MeiRain/DreamFly2/README.md

# DreamFly2

DreamFly2 是一个基于 STM32F411、HAL 和 FreeRTOS 实现的微型四轴飞行器项目。

项目源自本科阶段的 DreamFly。在保留原有硬件和飞行经验的基础上，新版本将重新整理驱动、算法、飞行控制和调试工具，最终实现室内低空的自稳、定高与光流定点飞行。

## 功能清单

### 工程基础

- [ ] 建立 STM32CubeMX + CMake + CLion 工程
- [ ] 接入 STM32 HAL 与 FreeRTOS
- [ ] 建立统一的工程目录、代码规范和调试接口
- [ ] 建立可重复编译和烧录的项目基线

### 板级驱动

- [ ] 系统时钟与基础定时
- [ ] 用户 LED
- [ ] WS2812B RGB 灯
- [ ] 四路空心杯电机 PWM
- [ ] 电池电压采样
- [ ] UART、SPI 与 I2C 总线
- [ ] 内部 Flash 参数保存

### 传感器与通信

- [ ] ICM20948 加速度计与陀螺仪
- [ ] BMP280 气压计
- [ ] 光流模块（vl53l1和pmw3901）
- [ ] 激光测距模块
- [ ] Si24R1 遥控通信
- [ ] ESP8684 Wi-Fi 调试数据传输

### 遥控器

- [ ] 建立 STM32F103 HAL 工程
- [ ] 双摇杆四通道 ADC 与电池电压采样
- [ ] 摇杆校准、死区和通道映射
- [ ] 六个功能按键
- [ ] 信息页切换、飞行模式选择与设置菜单
- [ ] OLED 状态显示
- [ ] WS2812B、状态 LED 与蜂鸣器提示
- [ ] NRF24L01 遥控数据发送与连接状态检测
- [ ] 内部 Flash 保存摇杆校准参数
- [ ] USB 转串口调试

### 飞行功能

- [ ] 传感器检测与 IMU 校准
- [ ] 姿态解算
- [ ] 角速度内环控制
- [ ] 姿态外环控制
- [ ] 电机混控
- [ ] 自稳飞行
- [ ] 高度估计与定高飞行
- [ ] 光流速度估计
- [ ] 室内低空光流定点
- [ ] 自动起飞
- [ ] 自动降落
- [ ] 解锁后四个电机低速短转提示

### 安全与调试

- [ ] 解锁与上锁状态管理
- [ ] 遥控失联保护
- [ ] 欠压保护
- [ ] 姿态异常保护
- [ ] 传感器异常处理
- [ ] PID 与传感器数据观察
- [ ] 飞行日志与问题记录

## 单回中油门约定

遥控器采用油门上下轴不回中的单回中设计；横滚、俯仰、偏航仍自动回中。油门松手保持当前杆位，最低 1000、中位 1500、最高 2000。

| 模式 | 油门含义 | 中位含义 |
|---|---|---|
| 自稳 | 杆位连续映射基础输出，驾驶者手动调节高度 | 固定杆量，不保证悬停，不强制映射悬停基准 |
| 定高 / 光流定点 | 上半请求上升、下半请求下降 | 手动放入 1450～1550 死区，请求保持高度 |

- **校准**：三轴居中、油门拉到底，采集三轴中点和油门最低值；旧版四中点参数不能直接沿用。
- **解锁待飞**：内八解锁，电机依次短转后停桨；三轴居中且油门 ≤1100 保持 200 ms，再上推。当前自稳台架到 ≥1200 启动，低杆 ≤1100 停止；中位不停止。
- **待飞保护**：提前推高不能启动；待飞 15 秒无操作自动上锁；失联或必要数据失效上锁，恢复后重新执行解锁和低杆确认。
- **正式模式**：定高／定点低杆是下降请求，不能套用台架低杆停机逻辑；落地后手动上锁，可靠落地检测接入后再实现自动上锁。

当前台架基础 PWM 已跟随 `油门值 − 1000`，单电机输出范围 0～1000，三轴修正仍各限 ±20；解锁短转仍为 PWM=100。横滚／俯仰已接角度—角速度双环，偏航按摇杆控制角速度；初始参数仍待验证，定高、定点和一键起降尚未接入。完整规则与 PX4 对照见 [单回中油门控制](docs/throttle.md)。

## 文档导航

| 文档 | 内容 |
|---|---|
| [文档索引](docs/README.md) | 全部开发文档与硬件资料入口 |
| [单回中油门控制](docs/throttle.md) | 单回中校准、低杆待飞、模式油门与落地上锁约定 |
| [遥控器操作](docs/remote_controls.md) | 按键分工、校准流程、解锁提示与一键起降规划 |
| [硬件配置与引脚映射](docs/hardware.md) | 飞控与遥控器硬件、外设接口和引脚对应关系 |
| [软件结构](docs/architecture.md) | 模块分层、依赖关系与数据处理原则 |
| [C 代码规范](docs/coding_style.md) | 命名、变量作用域、函数传值、头文件引用与注释 |
| [姿态解算](docs/attitude.md) | 新旧实现对比、运动修正条件与上位机方向映射 |
| [Flash 参数保存](docs/flash.md) | 参数区预留、构建配置、加载与保存 |
| [匿名上位机在线调参](docs/ano_parameters.md) | UART2/WiFi 连接、姿态增益读写、恢复默认与保存 |
| [遥控通信协议](docs/remote_protocol.md) | 控制包、状态包、字段单位与 ACK 约定 |
| [SI24R1 驱动](docs/si24r1.md) | 无线驱动接口与通信流程 |
| [开发与协作](docs/development.md) | 开发路线、分工与提交协作方式 |

## Flash 参数区配置

飞控使用末尾 128 KB（扇区 7）保存参数。在 `firmware/dreamfly2_flight/STM32F411xx_FLASH.ld` 的 `MEMORY` 中，将 Flash 的 `LENGTH = 512K` 改为 `384K`，RAM 配置不变：

```ld
FLASH (rx) : ORIGIN = 0x08000000, LENGTH = 384K
```

同时在飞控 `CMakeLists.txt` 的 `target_sources()` 中加入 `Core/Src/flash.c`。修改后重新构建。

`flight_init()` 自动加载参数；匿名上位机现已接入四个姿态解算增益的读取、修改、恢复默认和保存命令，支持 UART2 串口或 WiFi 双向透传。修改先在 RAM 生效，明确执行保存才写入 Flash；修改和保存要求飞控已上锁。UART2 报文读写、保存及掉电加载已通过实机验证；匿名上位机界面和 WiFi 透传尚待验证。详见 [在线调参](docs/ano_parameters.md) 和 [Flash 参数保存](docs/flash.md)。

## 项目状态

DreamFly2 正在重新整理和启动中。功能清单将随开发进度逐项更新。
