MeiRain/DreamFly2/docs/README.md

# 项目文档

[返回项目首页](../README.md)

## 使用与硬件

| 文档 | 内容 |
|---|---|
| [单回中油门控制](throttle.md) | 正式油门操纵约定、PX4 参考及当前台架差异 |
| [遥控器操作](remote_controls.md) | 功能键、微调键、校准与起降操作规划 |
| [硬件配置与引脚映射](hardware.md) | 飞控与遥控器硬件配置和接口表 |
| [硬件结构图](hardware_structure.png) | 飞控与遥控器硬件结构 |

## 软件设计与开发

| 文档 | 内容 |
|---|---|
| [软件结构](architecture.md) | 分层、模块依赖与实时处理原则 |
| [C 代码规范](coding_style.md) | 文件命名、函数接口、变量与注释规范 |
| [姿态解算](attitude.md) | 算法对比、修正门限与显示方向 |
| [Flash 参数保存](flash.md) | 预留 128 KB 参数区、默认值、有效性校验和保存接口 |
| [高度估计](height.md) | 气压相对高度、垂直加速度融合与调试输出 |
| [遥控目标映射](control_mapping.md) | 自稳/定高目标、油门死区和调试预览 |
| [开发与协作](development.md) | 开发路线和协作方式 |
| [板级验证](board_verification.md) | 高度回传、无线中断、遥控操作及拆桨电机验证记录 |
| [2026-10-27 实测记录](measurements/2026-10-27/README.md) | 气压与融合原始日志、统计及当前暂停位置 |

## 通信与驱动

| 文档 | 内容 |
|---|---|
| [匿名上位机在线调参](ano_parameters.md) | UART2/WiFi 参数列表、在线修改、恢复默认与保存 |
| [遥控通信协议](remote_protocol.md) | 遥控指令、飞控状态与链路约定 |
| [SI24R1 驱动](si24r1.md) | 驱动接口、ACK 和收发流程 |
