MeiRain/DreamFly2/docs/attitude.md

# 姿态解算实现对比

[返回项目首页](../README.md) · [文档索引](README.md)

三版均采用陀螺仪积分与加速度重力方向反馈的互补融合思路。DreamFly2 的区别主要是数据接口、状态管理和运动条件处理，并非全新的姿态算法。

| 对比项 | 原版 DreamFly | 江科大参考工程 | DreamFly2 |
|---|---|---|---|
| 输入与周期 | 原始计数经校准、滤波后输入；解算内部固定周期 | 加速度、角速度及 `dt` 由调用方传入，角速度单位为 °/s | `sensors` 提供校准、滤波后的 g、°/s；周期通过参数传入，当前任务设为 2 ms |
| 初始姿态 | 四元数从 `(1,0,0,0)` 开始 | 提供根据加速度初始化四元数的函数 | 首个有效加速度样本初始化 Roll、Pitch，Yaw 从零开始 |
| 六轴与九轴状态 | 当前飞行路径使用六轴 | 六轴、九轴函数共用全局四元数 | 六轴、九轴分别保存私有状态，可同时计算；六轴用于飞行开发，九轴用于演示 |
| 四元数积分 | 顺序更新，后面的分量使用已经更新的分量 | 同样顺序更新 | 先保存旧四元数，四个分量使用同一时刻的数据更新，再归一化 |
| 偏航角输出 | Z 轴角速度单独积分，设置 ±1°/s 死区；使用 `HALFT`，与四元数完整积分周期不一致 | 从四元数计算 Yaw，无该死区 | 从各自的四元数计算 Yaw，不忽略缓慢转动 |
| 加速度零值处理 | 任意一轴为零即退出，可能跳过正常样本 | 三轴全部为零才退出，避免归一化除零 | 六轴加速度不可靠时继续陀螺仪积分，不退出整个解算 |
| 动态重力修正 | 无加速度模长门限 | 无加速度模长门限 | 六轴只在加速度模长为 0.85～1.15 g 时使用重力方向修正 |
| 修正积分 | 每次累加重力方向误差 | 每次按 `dt` 累加重力方向误差 | 六轴仅在上述模长范围内、且每轴角速度均不超过 20°/s 时累加；其他时候保留已有积分修正 |

## 新版运动条件处理

加速度计在运动时测到的是重力与运动影响的合成量。模长明显偏离 1 g 时，暂停新的重力反馈；较快转动时，暂停修正积分累加，减少运动加速度和滤波滞后被积累为长期修正的机会。陀螺仪积分仍持续执行。

0.85～1.15 g 和 20°/s 是针对手持剧烈运动测试新增的初始参数，不来自旧版或江科大参考工程，也不是固定标准。目前仅完成初步手持验证，尚未验证飞行效果。模长接近 1 g 不保证没有运动干扰；这些门限也不能消除六轴的绝对航向不可观测问题。后续需检查采样周期、传感器饱和、零偏和动态误差，不能仅凭门限认定漂移根因已解决。

## 上位机方向映射

内部姿态和控制使用一致的机体坐标系。发送 ANO `0x03` 姿态帧时，在 `debug_send_attitude()` 中保留 Roll，对 Pitch、Yaw 取负，以匹配旧版上位机显示方向。该转换只作用于输出显示，不改变传感器数据或内部姿态状态。

实现文件：[`attitude.c`](../firmware/dreamfly2_flight/Common/attitude.c)、[`sensors.c`](../firmware/dreamfly2_flight/Application/sensors.c)、[`debug.c`](../firmware/dreamfly2_flight/Application/debug.c)。
