MeiRain/DreamFly2/docs/throttle.md

# 单回中油门控制约定

[项目首页](../README.md#单回中油门约定) · [遥控器操作](remote_controls.md) · [当前代码与台架](control_mapping.md)

设计确定日期：2026-10-29。本版替代此前双回中设计。只有油门上下轴不回中，偏航、横滚、俯仰仍回中；油门松手后保持当前杆位。所有通道仍为 1000～2000，通信包长度和字段不变。

## 摇杆采样与校准

- 校准时三轴居中、油门拉到底，按 5 ms 间隔取 60 次新样本，计算三轴中点和油门最低 ADC 值。
- 三轴中点允许 1024～3072，油门最低值允许 0～1024；姿势不符时失败，不覆盖旧参数。
- 各轴先独立均值滤波。三轴按各自中点映射到 1000～2000，保留 ±10 的中位死区；油门从实测最低值到理论 4095 映射到 1000～2000，仅保留底部 10 个通道单位的死区，不吸附到 1500。
- 尚未校准时三轴中点默认 2048、油门最低默认 0。未加入完整行程端点校准，最高端仍可能略低于 2000。
- 参数字段由 `throttle_center_adc` 改为 `throttle_min_adc`；旧四中点参数不能直接加载，需重新校准。当前只更新 RAM，遥控器 Flash 保存和上电加载尚未实现。

## 各模式的油门含义

| 模式 | 杆量控制 | 手动放在中位 | 最低位置 |
|---|---|---|---|
| 自稳 | 连续基础输出，手动维持高度 | 固定杆量，不保证悬停 | 零基础输出候选；实际停机由状态和输出策略决定 |
| 定高 | 垂直速度 | 目标升降速度为零，并由高度闭环保持高度 | 请求下降，不是停桨命令 |
| 光流定点 | 垂直速度；水平由光流等估计和控制 | 垂直目标同定高，三轴中位另用于水平及偏航指令 | 请求下降，不是停桨命令 |

自稳沿用 `throttle - 1000` 生成 0～1000 的候选基础 PWM，不再强制“中位=悬停基准”。实际电机驱动上限为 1000（ARR=999 时为100%占空比），当前台架另有限幅；候选值不是推力或电机转速。悬停位置要实测，电量、姿态和载荷变化都可能需要手动修正。横滚、俯仰中位请求水平姿态，偏航中位请求零角速度；六轴解算不保证绝对航向不漂移。

定高、光流定点采用中位 1450～1550 的零升降速度死区，杆量高于死区请求上升，低于死区请求下降；当前定高候选上限为 ±0.5 m/s。机械不回中，因此驾驶者必须手动回到中位才能停止升降请求。定高候选已存在，光流定点映射和两者完整控制闭环尚未实现。

## 解锁与运行入口

1. 上锁时不因杆量启动电机。内八保持 1.5 秒解锁，松开后再次内八上锁。
2. 保留 M3→M4→M1→M2（左前→左后→右后→右前）的依次短转：每个 200 ms，间隔 300 ms，随后停桨等待。
3. 短转结束后，横滚、俯仰、偏航在 1450～1550，油门 ≤1100，连续保持 200 ms，才进入等待上推。短转期间的低杆不计入；提前推高必须重新拉低确认。
4. 当前自稳台架油门 ≥1200 授予运行许可，不再要求油门居中或达到 1600。启动时三轴仍需居中；等待上推时偏离三轴中位会取消确认，需重新完成第 3 步。启动后允许三轴运动。
5. 若以后接入定高类模式，摇杆起飞入口使用 ≥1600，避免从低杆经过中位时触发；该入口检查不代表高度控制已经实现。一键起飞保留 SW4 长按规划，须待对应控制和动作确认接入。
6. 待飞阶段保留 15 秒无操作自动上锁，运行后不按无操作计时自动上锁。起飞请求／运行许可不等于已经离地。

## 当前台架与正式飞行的边界

当前 `FLIGHT_RATE_TEST_ENABLED=1`，基础 PWM 使用 `油门值 − 1000`，范围0～1000；每轴修正仍为 ±20，混控后每电机限制0～1000。已移除固定基础100和台架160上限，推杆会实际增加输出。解锁顺序短转独立保留PWM=100。油门 ≤1100 停止并重新进入待飞确认，1101～1199 为启动后的滞回区间；1500 不停止。

台架失联、必要 IMU 无效或内环结果过期时上锁，恢复后不会自行重转。当前已接入手动基础油门、横滚／俯仰角度—角速度双环和偏航摇杆角速度目标，初始参数尚未调好；定高、定点和自动起降未接入。关闭台架开关仍只做计算预览，除解锁短转外不驱动电机。

双环已接入，下一步核对反馈方向、调节内外环参数并验证控制权限；定高／定点低油门必须保持下降控制，不能沿用台架低杆停机。首次正式飞行接入前需分别检查各模式的输出、最低推力和失效处理。

## 模式切换与降落

- 油门不回中不消除模式切换差异：自稳中的固定推力杆位，在定高中可能是升降速度请求。切入定高／定点时需将杆量放入中位并平滑承接输出；退出到自稳也需处理当前实际输出与手动杆量的差异。
- 只允许切入估计与控制均可用的模式，不能只改显示标志。模式切换当前仍未接入，不新增未经验证的空中切换行为。
- 正式自稳靠减小推力降落；定高／定点靠低杆请求下降。落地后保持低杆并手动内八上锁；不能单用低油门、气压高度为零或短时静止判断落地。
- 后续落地检测结合离地经历、低输出、运动和有效测距等证据持续确认，确认后停桨并上锁。尚未实现自动落地检测，不能宣称接地会自动上锁。
- 上锁或失效后，新的启动必须重新完成解锁和低杆确认，不能因恢复通信、重复包或原杆量保持偏高就自动重启。已明确请求的受控降落也不能被按键重传解释成起飞。

## PX4 参考

PX4 自稳使用推力映射，定高／定点使用垂直速度控制。PX4 支持悬停推力重映射，也可选择不重映射；本项目现阶段选择简单的直接杆量候选映射，不强制中位悬停。PX4 定高文档的地面起飞阈值为全行程 62.5%；本项目低杆确认、1200 台架启动、1600 预留定高入口和解锁短转均为项目约定，并非照搬 PX4。

PX4 的落地检测有接地、可能已落地、已落地的持续确认，自动上锁还受 `COM_DISARM_LAND` 延时影响。它同样不能保证物理接地瞬间已上锁。

核对日期 2026-10-29；源码参考固定至 v1.17.0，在线文档可能随版本更新。

- [PX4 自稳与油门曲线](https://docs.px4.io/main/en/flight_modes_mc/manual_stabilized)
- [PX4 定高](https://docs.px4.io/main/en/flight_modes_mc/altitude)
- [PX4 定点](https://docs.px4.io/main/en/flight_modes_mc/position)
- [PX4 落地检测](https://docs.px4.io/main/en/advanced_config/land_detector)
- [v1.17.0 自稳油门曲线实现](https://github.com/PX4/PX4-Autopilot/blob/v1.17.0/src/modules/mc_att_control/mc_att_control_main.cpp)
- [v1.17.0 解锁检查](https://github.com/PX4/PX4-Autopilot/blob/v1.17.0/src/modules/commander/Commander.cpp)
