MeiRain/DreamFly2/docs/hardware_structure.png

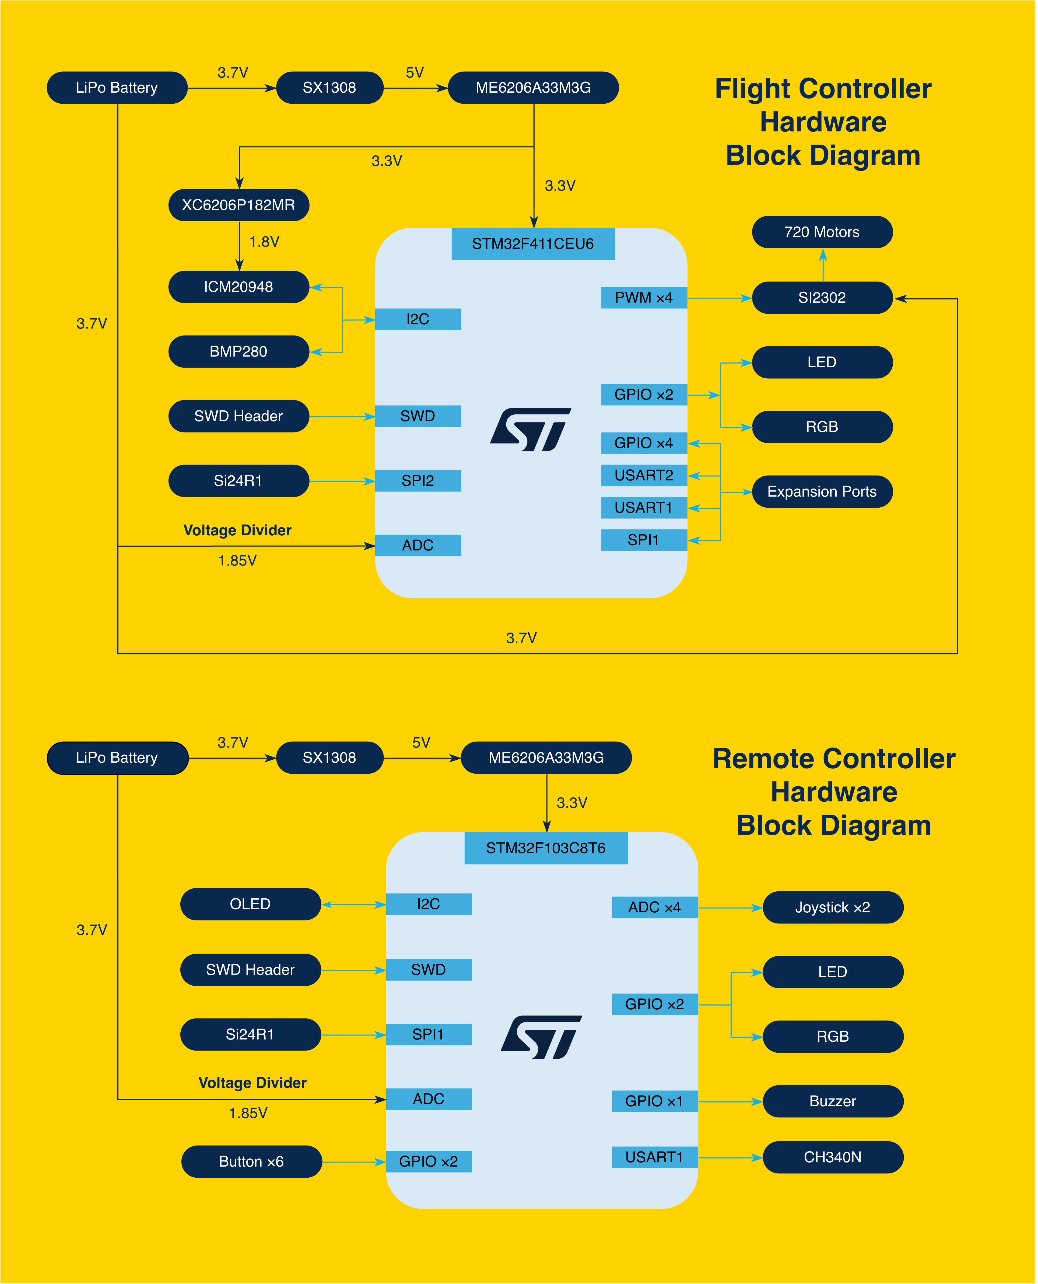
docs/hardware_structure.png
