MeiRain/DreamFly2/hardware/dreamfly/dreamfly2_data_transfer.png

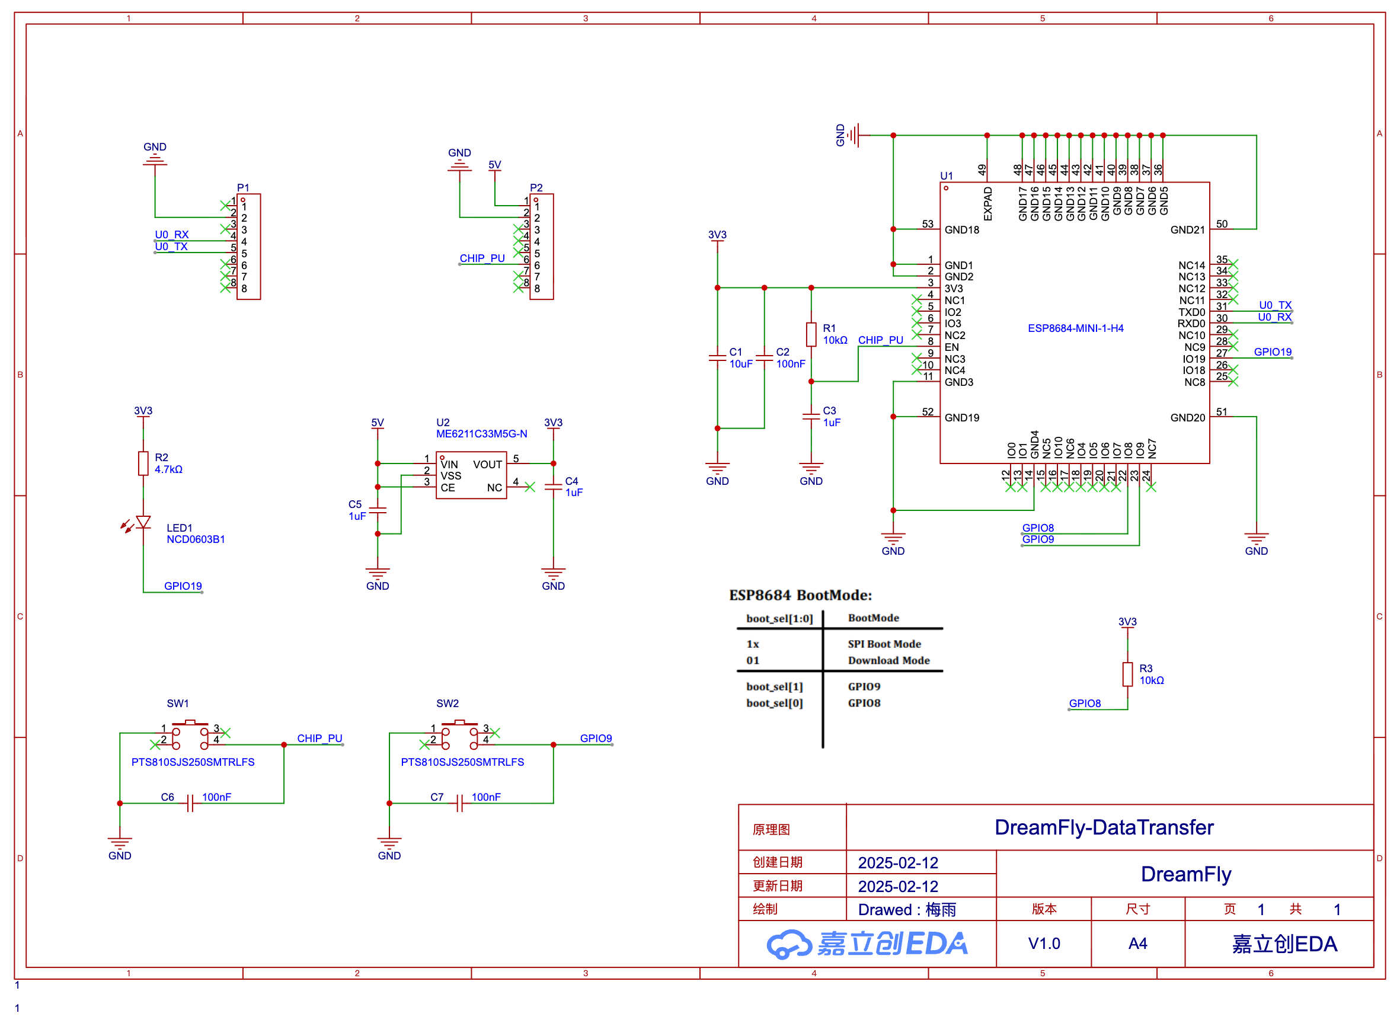
hardware/dreamfly/dreamfly2_data_transfer.png
