MeiRain/DreamFly2/hardware/dreamfly/dreamfly2_flight.png

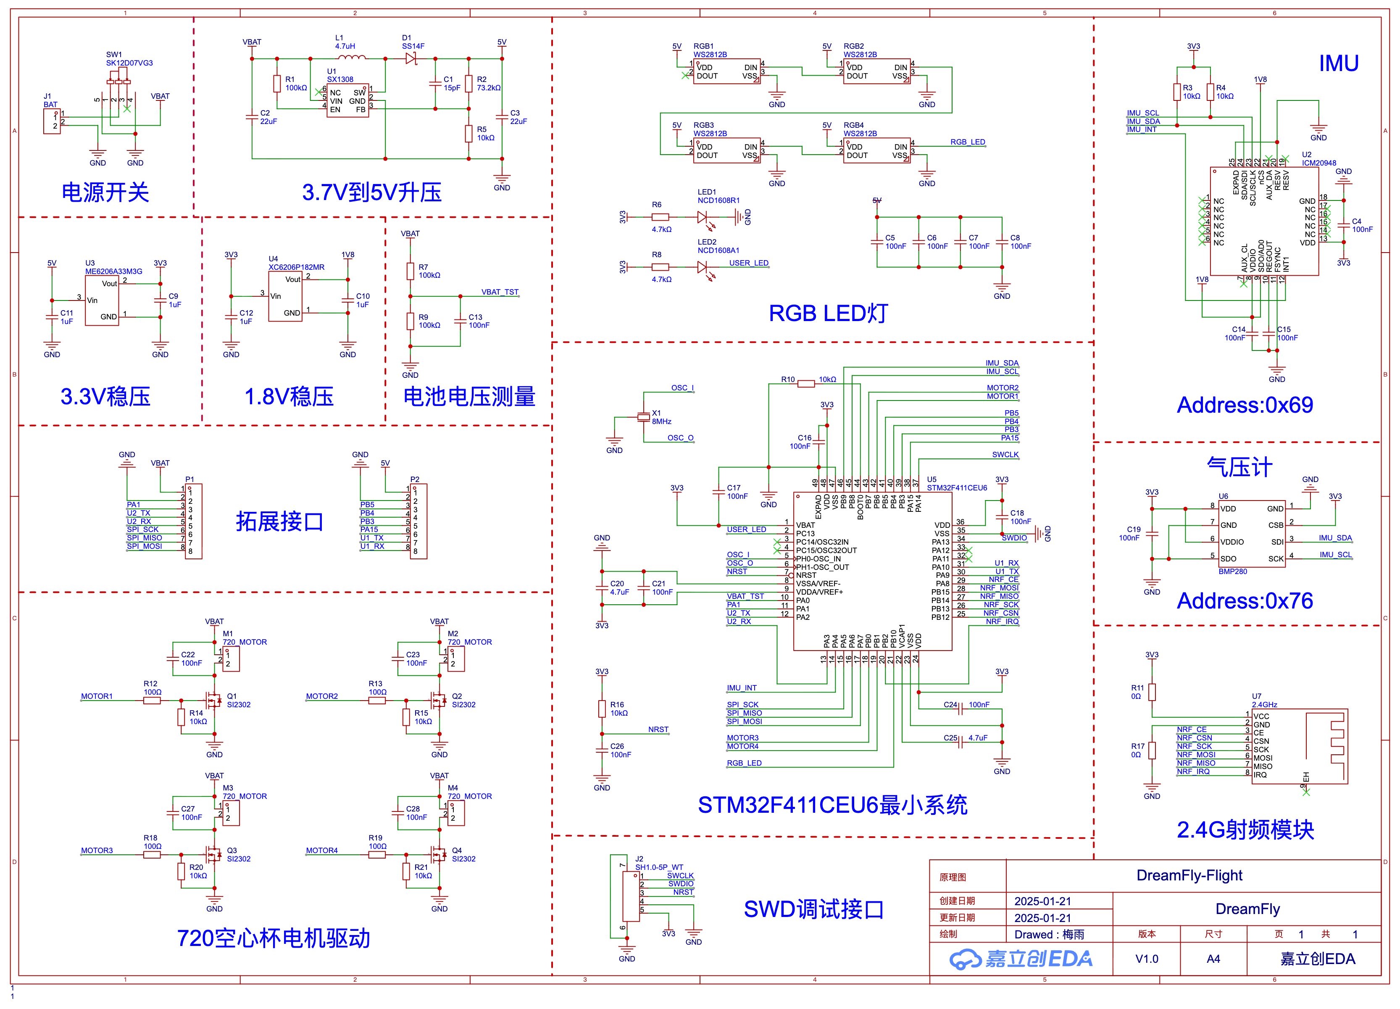
hardware/dreamfly/dreamfly2_flight.png
