MeiRain/DreamFly2/hardware/dreamfly/dreamfly2_optical_flow.png

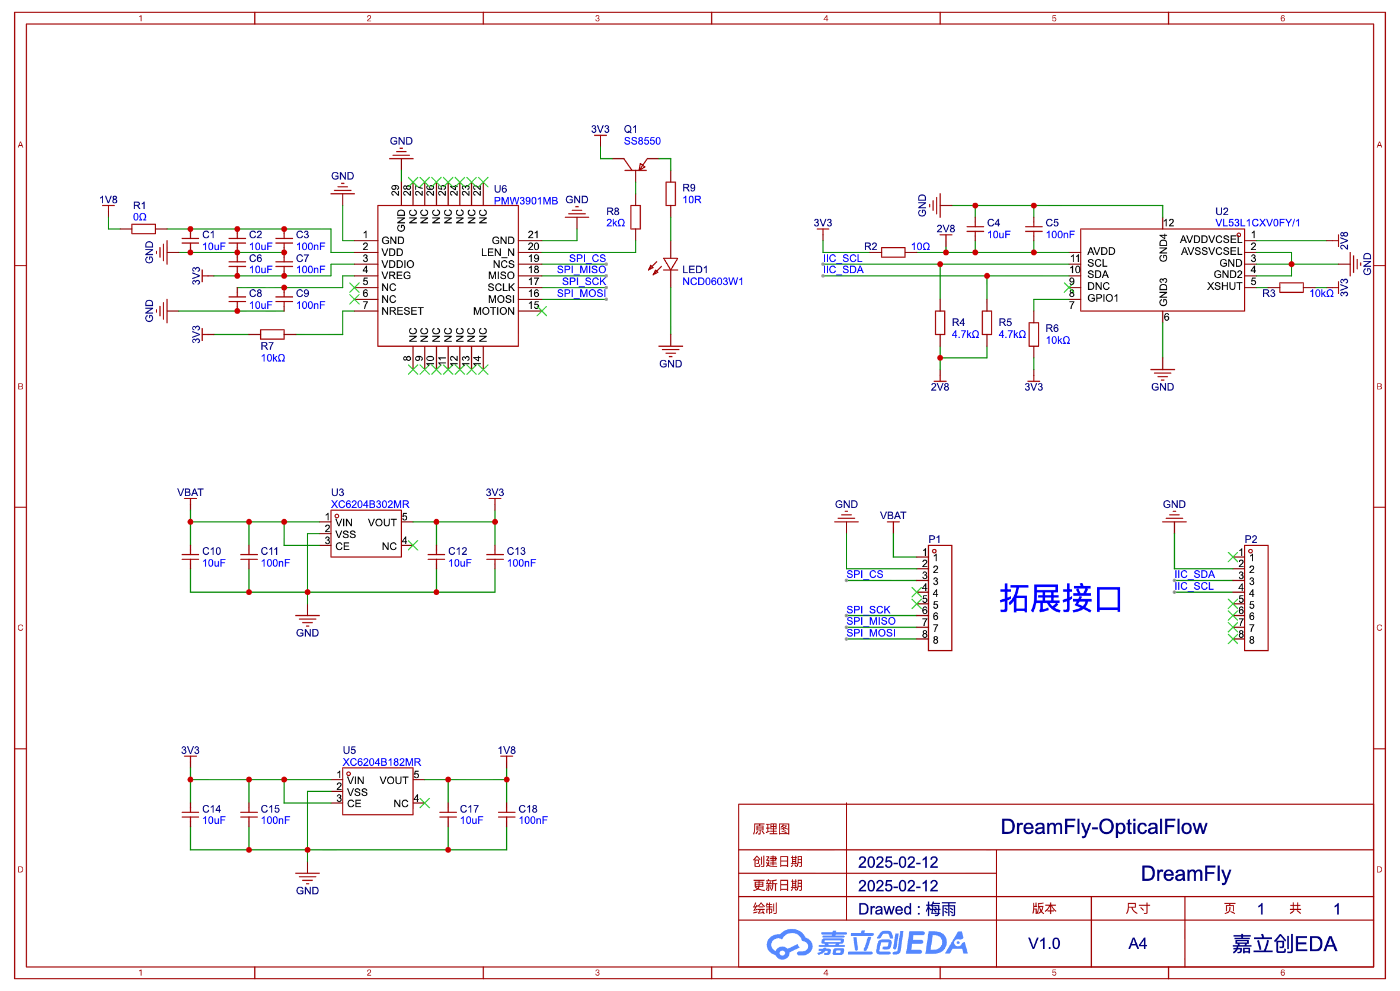
hardware/dreamfly/dreamfly2_optical_flow.png
