MeiRain/DreamFly2/hardware/dreamfly/dreamfly2_remote.png

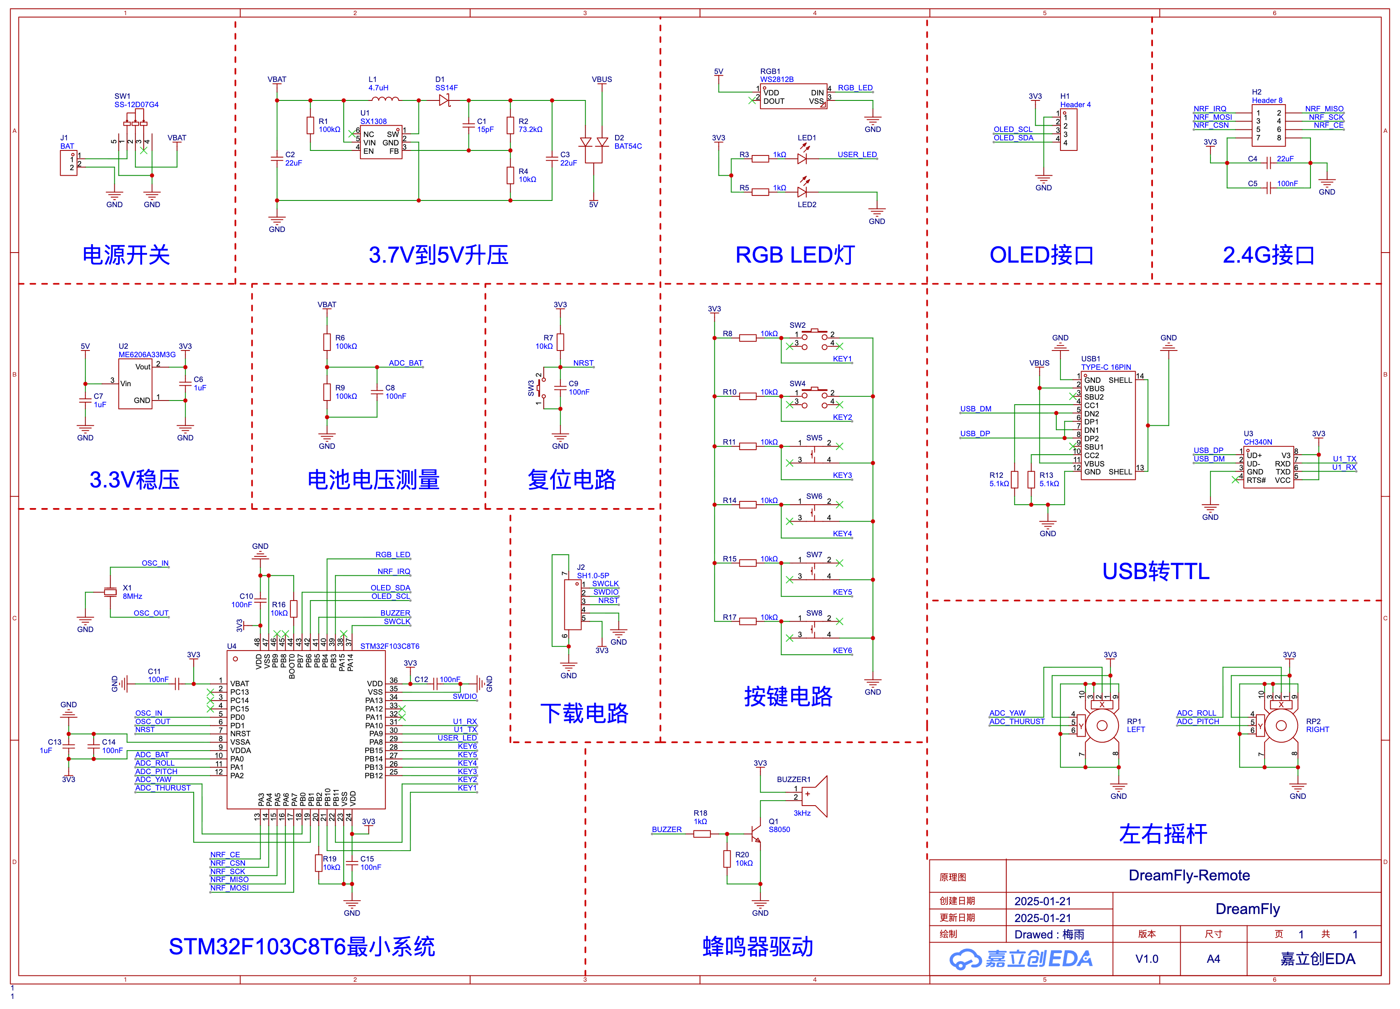
hardware/dreamfly/dreamfly2_remote.png
