MeiRain/DreamFly2/docs/measurements/2026-10-27/README.md

# 2026-10-27 气压高度与融合验证

[文档索引](../../README.md) · [高度估计](../../height.md) · [统计表](statistics.csv)

## 暂停位置

用户已暂时没有板子，停止板级采集。保留当前参数，不凭现有日志继续猜测调参。遥控通道到自稳/定高候选目标的映射已离线实现并接入调试，见[目标映射](../../control_mapping.md)，实际飞行电机输出仍未接入。下一步可接横滚/俯仰角度外环的候选输出；恢复板级验证时先补角度、去重力竖直加速度诊断，再定位倾斜假升降。

当前固件：BMP280 气压×16、温度×2、IIR4、0.5ms待机，任务50ms读取。气压地面零点仍是前32次有效海拔均值。融合位于 `Common/height.c/.h`，传感器任务调用，UART1对比 `H/F/Vz`；遥控器继续回传气压高度。用户已添加CMake源文件并自行编译、下载；本次代理没有编译或烧录。

## 关键数据与结论

| 记录 | 数据 | 结论与限制 |
|---|---|---|
| 已确认重新编译后的气压静置 | H=+7～+43cm，均值26.5cm，标准差8.71cm | 零点存在偏移，短时噪声仍明显 |
| 同轮抬高保持 | H均值85.81cm，标准差8.17cm | 相对本轮原位增加约59cm，方向正确 |
| 同轮放回 | 最后两个5秒窗口均值22.6、28.1cm | 接近原位；用户说明放回前等了一会，不能把整段等待算成传感器延迟 |
| 融合静置 | H标准差8.62cm；F标准差6.93cm；Vz=−8～+2cm/s | 这段融合更平滑，但速度仍有残差；不是定高控制验证 |
| 融合抬升 | Vz峰值约+31cm/s，F随抬升增加 | 上升方向初步验证；无精确位移、速度真值 |
| 融合放回 | Vz最低约−51cm/s，之后逐渐回零附近 | 下降方向初步验证，仍有数cm/s残差 |
| 原地倾斜 | H=−39～+12cm；F=−40～+11cm；Vz=−13～+8cm/s | 没有持续发散，但假升降明显；未同步记录Roll/Pitch/竖直加速度，不能确认重力补偿通过 |

用户反馈：电机依次转动正常，可记为该提示效果的实测反馈，不能据此认定失联保护、全部手势和实际飞行控制已通过。飞控 `rx` 和PB2 `irq` 计数增长已读到；遥控器PB3实际中断触发未单独证明，因仍有周期兜底。

## 不能混用的旧记录

- `dreamfly2_height_stage*.json`：最早的IIR16轮次，位置/环境未完全控制；不据此宣称传感器精度。
- `dreamfly2_height_filter4_stage*.json`：气压×4、温度×1、IIR4轮次。用户说明位置变到了灯泡附近/不同格子，温度条件也改变，不能直接归因于滤波系数。
- **`dreamfly2_height_os16_filter4_stage*.json` 文件名有误导性**：当时Debug ELF生成于13:51，而×16/50ms源码修改于13:57，尚未重新编译。该组不能作为新配置结果。原文件名保留用于追溯，统计表明确标记排除。
- `dreamfly2_height_os16_rebuilt_stage*.json`：核对ELF与相关目标文件均更新到14:01之后的有效新配置轮次。
- `dreamfly2_height_fusion_*.json`：核对 `height.c.obj` 和ELF更新到14:24之后的融合轮次。

## 原始日志格式与后续待办

每个JSON是 `[记录开始后的秒数, 串口原文]` 数组，保留该段收到的全部文本。它没有精确动作时间戳；“看到提示”与实际抬升/放回时间不完全同步，不能用采集开始时间直接计算阶跃延迟。UART1诊断约每400ms一行，统计表基于打印后的整数值，不代表完整500Hz融合数据。包含运动的整段标准差不能当作静态噪声。

尚待验证/处理：

- 同步Roll、Pitch、去重力竖直加速度，检查固定倾角保持后的残余加速度，区分姿态误差、滤波滞后、手持位移和气压干扰。
- 当前前32次气压均值没有“温度稳定后再归零”的处理；飞行中不应持续重新归零。
- 融合参数是台架起点，尚未完成定高PID、融合高度回传或飞行闭环。起飞请求只锁存，不实际起飞。
- 下次采集应固定位置、握持方式与环境，并明确动作时刻；不急于继续增加软件滤波或温漂补偿系数。
