MeiRain/DreamFly2/docs/board_verification.md

# 板级验证记录

[文档索引](README.md)

当前操作以单回中验证章节为准；下方旧版回中入口及日志保留作历史记录，不作为当前下载指引。历史检查包括无线中断、双向回传、按键与摇杆、传感器显示、解锁与电机顺序提示、回中后的起飞请求。全部实机结果仍待填写，代码检查不代表板级通过。先拆除四个螺旋桨；当前固件解锁后会实际启动电机提示，尚未实现飞行、定高或自动起降。

## 单回中修改后的验证（2026-10-29，待验证）

本版飞控和遥控器均需由用户重新编译下载，底层配置与通信包不变。油门上下轴不回中，三轴仍回中。先拆桨；当前仍是限幅台架，不是正式飞行控制。

1. 上锁且连接正常，在 REMOTE 页将三轴居中、油门拉到底，长按 SW2 校准。成功后检查三轴约1500、油门最低1000；油门全程不应在1500附近吸附。
2. 内八解锁，确认 M3→M4→M1→M2 依次短转，随后停转。若提前推高并保持，短转结束后仍不能启动台架。
3. 三轴1450～1550、油门≤1100保持至少200 ms，确认U1 `O`四路为0、`run=0`。保持三轴居中，上推到≥1200，确认`run=1`，油门1200静止时O接近200。
4. 将油门移到1500再放低至1200，台架应持续运行；拉低到≤1100才停止。未重新低杆确认200 ms就立即推高，不能重启。
5. 等待上推时先偏转一个姿态轴，确认本次准备被取消，必须重新三轴居中且低杆确认才能启动。
6. 运行中断开遥控器，确认失联上锁停转；恢复连接、保持高杆不能自行重转。再次启动需重新解锁与低杆确认。
7. 解锁待飞15秒无操作应自动上锁；启动后不因杆量保持不动而触发这项待飞超时。校准期间停止控制包发送的既有行为保留。

当前基础PWM使用`油门值−1000`，三轴修正±20，每电机0～1000；继续上推会增加输出，解锁短转独立保留PWM=100。本轮未编译、烧录或板测。详情见[单回中油门](throttle.md)和[台架模式](control_mapping.md#拆桨角速度台架模式)。

## 双环接入后的核对（2026-10-29，待验证）

当前飞控已由三轴零角速度试验改为横滚／俯仰双环，偏航直接跟随摇杆角速度。此前单环“倾斜后停止运动，四路恢复相同”的预期已不适用；三轴回中但机体倾斜时，应持续产生扶平修正。

先上锁、拆桨，通过U1核对：右倾保持时S横滚为负，M1/M2增大；低头保持时S俯仰为负，M2/M3增大；放平后修正减小。O上锁时仍为0。右推偏航杆对应负S偏航、M1/M3增大；松手目标角速度为0，不请求回到原航向。

外环初值P=3、输出±100deg/s，内环保留P=2、I=D=0、输出±20PWM计数。积分门控和同帧传感器发布已接入；未编译、烧录或板测。当前PID参数不在已有四参数Flash记录中。完整流程与日志字段见[串级控制](control_mapping.md)。

## 冷启动全红闪烁排查（2026-10-29，待验证）

四颗RGB一起红闪对应IMU初始化／陀螺仪校准失败，或水平加速度校准失败。代码检查发现首次访问ICM20948前缺少上电等待；手册的寄存器可访问时间最长100 ms，重新烧录造成的额外上电时间可能掩盖此缺口，但尚不能仅凭现象确认根因。

本版在首次寄存器访问前等待100 ms，保留复位后100 ms等待，配置后额外等待50 ms再采集校准。初始化／陀螺仪采集失败最多重新尝试三次；保持原有运动判断和水平校准门限，不绕过校准、不修改Flash参数、不在飞行任务中自动重初始化。

U1无效行新增`boot`：`boot=0`表示IMU配置或陀螺仪校准未完成；`boot=1 cal=0`表示水平加速度校准失败；`boot=1 cal=1 imu=0`表示启动校准通过但当前采样／姿态无效。各失败均保持不允许解锁。RGB仍报告故障，不因重试失败而隐藏。

用户编译下载后，拆桨、机体水平静置，分别重复完全断电上电及复位启动。成功后再验证单回中入口。若再红闪，保留异常状态并提供U1（115200）完整`rate: INVALID ...`一行，先区分失败阶段，不反复烧录覆盖现象。本版未编译、烧录或板测。

[ICM20948官方手册，第14页上电时序、第11页陀螺仪启动时间](https://product.tdk.com/system/files/dam/doc/product/sensor/mortion-inertial/imu/data_sheet/ds-000189-icm-20948-v1.5.pdf)

## 历史下载与观察（旧版流程）

以下轮播日志及相应检查步骤是早期验证格式。当前 UART1 已改为每 20 ms 单行输出角速度内环和混控预览，不再输出这些历史日志；当前格式见 [混控计算预览](control_mapping.md#角速度内环与混控计算预览)。

由用户编译、下载飞控；遥控器使用已有支持 18 字节状态包的版本即可，本次未修改遥控器。无需增加源文件或调整 CubeMX/CMake。飞控 UART1 为 115200、8N1，UART2 保留现有匿名姿态输出。

UART1 每 100 ms 选择一条消息输出，状态变化消息优先；普通情况下轮流出现遥控、板级和气压诊断消息：

```text
rc: OK rx=123 seq=122 R=1500 P=1500 Y=1500 T=1500 K=00
board: imu=1 cal=1 mag=1 baro=1 V=3.85 H=+12cm arm=0 req=0 irq=130
baro: P=101370.00Pa T=28.00C H=+12cm F=+10cm Vz=+1cm/s age=8ms
target[STAB]: R=0.0deg P=0.0deg Y=0.0dps Th=500 Vz=0.000m/s (preview)
```

- `imu/cal/mag/baro`：IMU、加速度校准、磁力计和气压计的初始化/校准结果，不等同于实时健康监测。
- `V`：飞控电池电压；0.00 表示尚无可用值，不代表物理电池一定为零。
- `baro`诊断行的`P/T`：BMP280输出的补偿气压和温度（仍受芯片滤波影响）；`age`：距上次成功读取的毫秒数。`F/Vz` 为融合高度/升降速度（cm、cm/s），向上为正，无有效融合结果时为横线；融合参数尚待实测。
- `H`：气压相对高度；`----` 表示参考未就绪、数据过期或超出协议范围。
- `arm`：解锁状态；`req`：油门起飞请求锁存值，不是已经起飞。
- `irq`：飞控 PB2 回调实际收到的无线中断次数，正常通信时应增长；它不等于包数，也不能单独证明遥控器 PB3 中断正常。
- `target`：新加入的映射预览，单位为deg、deg/s和m/s；其中Vz为目标速度，与baro行中的估计Vz不同。尚未接入PID、电机或模式切换，见[目标映射](control_mapping.md)。
- `rx`：飞控接受的有效新控制包数；`WAIT/LOST/ERROR` 分别表示未收到、超时、无线驱动故障。

## 历史验证顺序（旧版流程）

| 顺序 | 操作 | 预期 | 实机结果 |
|---|---|---|---|
| 1 | 两端平放上电，不动摇杆 | 传感器初始化/校准完成；电机不转；`arm=0 req=0` | 待验证 |
| 2 | 两端正常通信，观察 5 秒 | `rc: OK`，`rx`、飞控 `irq` 持续增长；遥控器信号格和飞行数据更新 | 待验证 |
| 3 | 进入 REMOTE 页，分别推动四轴 | LH=偏航、LV=油门、RH=横滚、RV=俯仰；居中约1500，打满接近1000/2000；UART1通道一致 | 待验证 |
| 4 | SW2 短按切页；REMOTE 页 SW4 短按返回 | 两页切换正常；短按不触发长按行为 | 待验证 |
| 5 | 未解锁且已连接，四轴手动居中，在 REMOTE 页长按 SW2 | 校准约0.3秒，显示 `CAL OK (RAM)`，回中约1500；本轮不验证Flash保存 | 待验证 |
| 6 | 不解锁，缓慢倾斜、旋转飞控 | 遥控器 R/P/Y 和 UART2 匿名姿态随动；方向逐轴核对 | 待验证 |
| 7 | 保持平放直到高度出现 | 32次有效读数建立参考，正常约1.6秒（从开始气压采样算）；H接近0，允许噪声 | 待验证 |
| 8 | 不解锁，缓慢抬高约50～100cm，再放回 | H总体上升为正，回原位接近原值；UART1与OLED大体一致，不要求厘米级精度 | 待验证 |
| 9 | 核对两页电池和信号图标 | FLIGHT用飞控电池、REMOTE用遥控器电池；电压用万用表对照；四格仅为电压分档 | 待验证 |
| 10 | 回到FLIGHT页，内八保持1.5秒 | 输出 `ARMED`；M3→M4→M1→M2（左前→左后→右后→右前）依次短转，每个转200ms，中间停300ms，总计约1.7秒，之后停转，`arm=1` | 待验证 |
| 11 | 持续保持内八超过3秒 | 不重复短转、不反复解锁上锁 | 待验证 |
| 12 | 松开，再内八保持1.5秒 | 输出 `LOCKED`，`arm=0 req=0`，电机停转 | 待验证 |
| 13 | 再解锁，短转结束前就将油门推高并保持 | 短转后停转，`req=0`；未经历四轴回中，不产生起飞请求 | 待验证 |
| 14 | 四轴回中1450～1550保持至少200ms，再上推油门到1600以上 | `TAKEOFF REQUEST (controller not connected)`、`req=1`；电机仍停转；持续上推不重复请求 | 待验证 |
| 15 | 已解锁时关闭遥控器 | 约300ms失联，上锁并清除请求，电机停止；OLED端断链则隐藏旧数据 | 待验证 |
| 16 | 恢复遥控器；另测飞控断电再上电 | 自动恢复正常收发但不自动解锁；状态/信号和新数据恢复 | 待验证 |
| 17 | 解锁后确认校准被拒绝；短转期间关闭遥控器 | 校准不应启动；失联被判定后终止剩余电机提示 | 待验证 |

气压测高受温漂、气流和电机影响；先在电机不转时检查方向与变化量，再观察短转后的扰动。不要因地面数据漂移而在飞行中持续重置零点。

### 气压滤波对照

第一轮对照仅把 BMP280 硬件 IIR 系数由16改为4，采用温度×1、气压×4、20ms读取。已采集静置/抬高/放回日志，观察到静置波动增加；因位置和温度条件变化，不能据此量化滤波带来的响应改善。

当前第二轮配置保留 IIR4，改为温度×2、气压×16过采样、50ms（20Hz）读取，降低测量噪声；Normal模式、0.5ms待机、地面零点和高度算法不变。初始化读回 `CONFIG=0x08`、`CTRL_MEAS=0x57`，不一致则初始化失败；`baro=1` 表示初始化检查通过，不代表已经排除漂移。32次有效读数建立地面零点约需1.6秒，尚不包含等待温度稳定的额外阶段。

用户重新编译、下载后，保持未解锁、电机停转，以相同的原位置和抬升高度重复三阶段采集。重启会重新建立地面零点，因此应比较每轮的高度变化量和回落过程，不能直接比较两轮的高度绝对值。该改动尚待板级对照，不预先认定它能消除静置漂移。

## 仍需单独确认的功能

气压×16、温度×2、IIR4、50ms读取的新配置已在重新编译后进行三阶段采集：原位平均约27cm、抬高后约86cm、返回原位后约25cm；静止高度标准差约8～9cm。用户说明放回前等待了一会，不能把记录开始到下降的时间全部算作传感器延迟。用户反馈电机依次转动正常；这不等同于所有解锁/失联保护均通过。新接入的高度融合尚未进行板级验证，见[高度估计](height.md)。

- 遥控器 PB3 中断：可在遥控器调试器中给 `HAL_GPIO_EXTI_Callback`（PB3分支）设一次断点确认；该项应在未解锁时进行，断点会改变通信时序。通信正常本身不能证明中断有效，因为仍有5ms轮询兜底。
- 四个方向键：逐个对照 REMOTE 页面前后的UART1 `K` 位；当前只发送状态，尚未接入飞控微调。
- LED/RGB：检查原有心跳LED与遥控器绿色测试灯；连接/异常灯光规则、蜂鸣器提示尚未自动接入，不能通过这一流程宣称全部验证通过。
- SW4主页面的模式/起降仍是未接入提示；气压高度只是回传，未接高度闭环。九轴演示受磁场和校准影响，另行测试。
- Flash保存、自动起降、实际飞行控制、光流/激光驱动接入及故障自动重初始化不属于已完成项。

先记录步骤1～8的串口和屏幕现象，再进行电机步骤，遇到不符先停在该项排查。

## UART2 在线调参（2026-10-28）

通过脚本收发匿名 V8 报文，已验证设备查询、四个参数信息/数值查询、在线修改与回读、确认帧、Flash 保存及掉电加载。临时保存的六轴 KP=0.801 在用户断电重启后读回一致；收尾已恢复六轴 0.8/0.0003、九轴 0.2/0.1，并重新保存成功。

本项仅覆盖 UART2 报文链路及四个姿态增益的持久化，不能代替匿名上位机界面、WiFi、恢复默认命令和飞行控制验证。此前清单中的其他待验证项保持原状态。详见 [在线调参记录](ano_parameters.md#uart2-实机记录2026-10-28)。

## 电机输出入口整理后的验证（2026-10-28）

用户重新编译、下载电机输出入口整理后的固件，并反馈所列现象均正常：

- 上电初始化期间四个电机不转。
- 内八解锁后，M1→M2→M3→M4 依次短转，结束后全部停止。
- 松开、回中后再上推油门，电机仍停止；当前只记录起飞请求。
- 松开后再次内八上锁，电机保持停止。
- 解锁短转期间关闭遥控器，失联后停止剩余短转。
- 解锁后、起飞请求前无摇杆或按键操作，约 15 秒后自动上锁。

以上为用户按验证步骤给出的整体反馈，未另采集时间测量或串口日志，不能据此宣称 200/300 ms 时序和 300 ms 失联延迟经过精密测量。此次验证未接入混控或角速度闭环电机输出。

后续接入前仍需确认实机 M1～M4 的安装位置、旋向及 IMU 机体系方向。旧工程横滚和偏航环使用负增益，应把控制方向与数值增益分开核对，不直接套用旧参数。

### 解锁提示顺序调整

用户随后确认位置：M1 右后、M2 右前、M3 左前、M4 左后（俯视、机头朝前）。解锁提示现改为 M3→M4→M1→M2，即左前→左后→右后→右前；200 ms 短转和 300 ms 间隔不变。此新顺序尚未重新编译下载验证，上述已通过记录对应调整前顺序。旋向另行确认，未接实际混控。

## UART1 调试输出清理

按用户要求，删除旧轮播日志、IMU CSV、状态变化文本及两组调试模式开关。当前仅输出 `rate: G=... U=... M=... valid=...`，数据不可用时输出简短的 `rate: INVALID ...`。未改变 UART2 协议、无线 IRQ 通知或实际电机输出，未编译下载验证。

## 内环与混控预览的三轴核对

用户编译下载后，助手只读采集 U1，按阶段完成右倾、低头和俯视顺时针转机头：右侧 M1/M2、前侧 M2/M3、偏航 M2/M4 的预览输出分别增大，方向符合预期；动作停止后四路回到约 500。此项验证了候选计算方向，尚未验证实际电机闭环，未调 PID、未写 Flash。原始数据与统计见 [2026-10-28 实测记录](measurements/2026-10-28/rate_preview/README.md)。

## 拆桨角速度内环台架输出（2026-10-28 旧版记录）

以下保留当时的阈值与验证状态，当前操作改用文首单回中步骤。用户当时同意进入限幅实际电机响应验证。当时 `FLIGHT_RATE_TEST_ENABLED=1`，完成解锁短转、回中确认、油门 ≥1600 后，允许固定基础 PWM=100、三轴修正各 ±20、每电机最高 160 的零角速度反馈；回中/拉低到 ≤1550 停止，失联或 IMU/PID 失效则上锁。U1 新增 O（实际写给驱动的命令）和 run（内环台架运行标志）。此阶段用户已编译下载，助手通过 U1 确认上锁时 O 为四个零、run=0；尚未完成台架运行和实际电机响应验证。操作见 [台架模式](control_mapping.md#拆桨角速度台架模式)。
