MeiRain/DreamFly2/docs/measurements/2026-10-28/rate_preview/README.md

# 角速度内环与混控预览实测（2026-10-28）

[返回当日记录](../README.md) · [控制映射](../../../control_mapping.md)

用户编译下载，助手通过 U1（115200、8N1）只读采集，用户按提示依次完成静置、右倾、低头、俯视顺时针转机头和停止保持。遥控器已连接、未解锁，四轴居中，基础油门预览约 500。所有 M 值均为计算预览，不是实测电机输出。

## 结果

| 动作 | 主轴数据方向 | M1/M2/M3/M4 预览均值 | 判断 |
|---|---|---|---|
| 静止基准末段 | 三轴角速度接近 0 | 500 / 500 / 500 / 500 | 正常 |
| 右侧压低 | Gx 正 | 522.30 / 520.98 / 477.09 / 479.68 | 右侧 M1/M2 较大，方向符合预期 |
| 机头压低 | Gy 正 | 488.45 / 512.52 / 509.63 / 489.45 | 前侧 M2/M3 较大，方向符合预期 |
| 俯视顺时针转机头 | Gz 负 | 462.58 / 537.38 / 462.22 / 537.78 | M2/M4 较大，按候选旋向产生反向偏航力矩 |
| 停止保持末段 | 三轴角速度接近 0 | 500.01 / 500 / 500 / 500 | 角速度目标为 0，停止转动后修正回落 |

计算配置为机体 X 向前、Y 向左、Z 向上；M1 右后、M2 右前、M3 左前、M4 左后，候选旋向 M1/M3 逆时针、M2/M4 顺时针。手持动作与原始 IMU 三轴的方向关系初步符合这一约定；电机实际反作用力矩未在本轮验证。

## 数据与统计口径

- `capture.jsonl.gz`：完整只读采集，逐行包含主机 UTC 接收时间、阶段名及串口原文；有效行还保留 G/U/M 数组。
- `summary.json`：阶段统计、筛选规则及代表性原始行。
- 动作阶段包含拿起、回平、转动和手抖，表中动作均值只选目标方向主轴角速度大于 5 deg/s、其他两轴绝对值各小于主轴 35% 的样本：右倾 91 点、低头 135 点、顺时针偏航 104 点。完整数据未删去反向或跨轴动作；该筛选用于分离动作，不能替代独立角度基准。
- 静止基准和最终保持均取最后 250 个有效样本。
- 初次采集串口短暂断开，重连后继续记录；准备阶段有 83 行候选不可用，重连首行不完整，均未用于上述动作统计。动作阶段及末段解析行均为 `valid=1`。
- 串口未输出 MCU 采样时间，主机可能成批接收数据；不以接收时间积分角度，也不由此声称控制延迟或准确采样周期。

## 结论范围

三轴计算反馈方向及停止动作后的预览回落符合预期。本轮没有发送任何串口控制命令，没有写参数、写 Flash、自动编译或烧录，也没有接入实际电机闭环。部分拿取/跨轴动作使 P 输出触及 ±100 的占位限幅，不能把本轮测试视为飞行 PID 已调好、推力分配已验证或允许起飞。

后续是拆桨、受限输出的实际电机反馈验证，再逐步完成内环调参与姿态外环。
