MeiRain/DreamFly2/docs/measurements/2026-10-27/statistics.csv

file | configuration_note | field | samples | min | max | mean | population_stddev | unit
dreamfly2_height_filter4_stage1.json | earlier_round_environment_not_controlled | H | 25 | -14 | 39 | 15.32 | 14.729 | cm
dreamfly2_height_filter4_stage2.json | earlier_round_environment_not_controlled | H | 25 | 28 | 77 | 53.72 | 12.118 | cm
dreamfly2_height_filter4_stage3.json | earlier_round_environment_not_controlled | H | 63 | -10 | 113 | 49.429 | 31.368 | cm
dreamfly2_height_fusion_lift.json | os16_t2_iir4_50ms_rebuilt | H | 62 | -26 | 72 | 23.79 | 31.137 | cm
dreamfly2_height_fusion_lift.json | os16_t2_iir4_50ms_rebuilt | F | 62 | -21 | 66 | 24.032 | 30.547 | cm
dreamfly2_height_fusion_lift.json | os16_t2_iir4_50ms_rebuilt | Vz | 62 | -6 | 31 | 2.919 | 7.367 | cm/s
dreamfly2_height_fusion_return.json | os16_t2_iir4_50ms_rebuilt | H | 62 | -37 | 60 | 8.081 | 29.468 | cm
dreamfly2_height_fusion_return.json | os16_t2_iir4_50ms_rebuilt | F | 62 | -28 | 55 | 8.387 | 28.787 | cm
dreamfly2_height_fusion_return.json | os16_t2_iir4_50ms_rebuilt | Vz | 62 | -51 | 12 | -1.742 | 9.985 | cm/s
dreamfly2_height_fusion_stage1.json | os16_t2_iir4_50ms_rebuilt | H | 25 | -2 | 34 | 17.36 | 8.625 | cm
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
