MeiRain/DreamFly2/docs/measurements/2026-10-28/imu_statistics.csv

file | samples | tail5s_roll_mean_deg | tail5s_roll_std_deg | tail5s_pitch_mean_deg | tail5s_pitch_std_deg | tail5s_roll_minus_acc_reference_deg | tail5s_pitch_minus_acc_reference_deg
kp02_ki0_pitch_hold.json | 501 | -0.22832 | 0.02381 | -31.41588 | 0.73451 | 0.00319 | 0.24216
kp02_ki0_pitch_return.json | 501 | 0.11155 | 0.00711 | -0.19112 | 0.01529 | 0.07259 | -0.15349
kp02_ki0_roll_hold.json | 601 | -31.671 | 0.76859 | 0.84151 | 0.02512 | -0.97618 | 0.2539
kp02_ki0_roll_return.json | 601 | -0.0341 | 0.02667 | -0.06458 | 0.01003 | -0.07159 | -0.00702
kp02_ki0_static.json | 501 | 0.05765 | 0.00603 | 0.06426 | 0.00548 | 0.0367 | 0.07592
kp05_ki0_motion.json | 1102 | 7.739 | 11.61224 | 10.26924 | 14.69825 | -0.13931 | -0.14459
kp05_ki0_motion_tail.json | 501 | 0.10056 | 0.01095 | -0.03538 | 0.00537 | 0.05848 | -0.02866
kp05_ki0_pitch_hold.json | 401 | -0.59861 | 0.13464 | -29.05072 | 3.79217 | -0.09912 | 0.06355
kp05_ki0_pitch_return.json | 501 | 0.07036 | 0.0078 | -0.04112 | 0.00705 | 0.06913 | -0.04429
kp05_ki0_roll_hold.json | 401 | -30.77299 | 0.25261 | 0.33008 | 0.01589 | 0.1182 | 0.04813
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
