MeiRain/DreamFly2/docs/PDF_DreamFly_2026-09-01/Schematic1/SCH_Schematic1_1-DreamFly-Flight_2026-09-01.pdf

# IMU

# 3.7V到5V升压

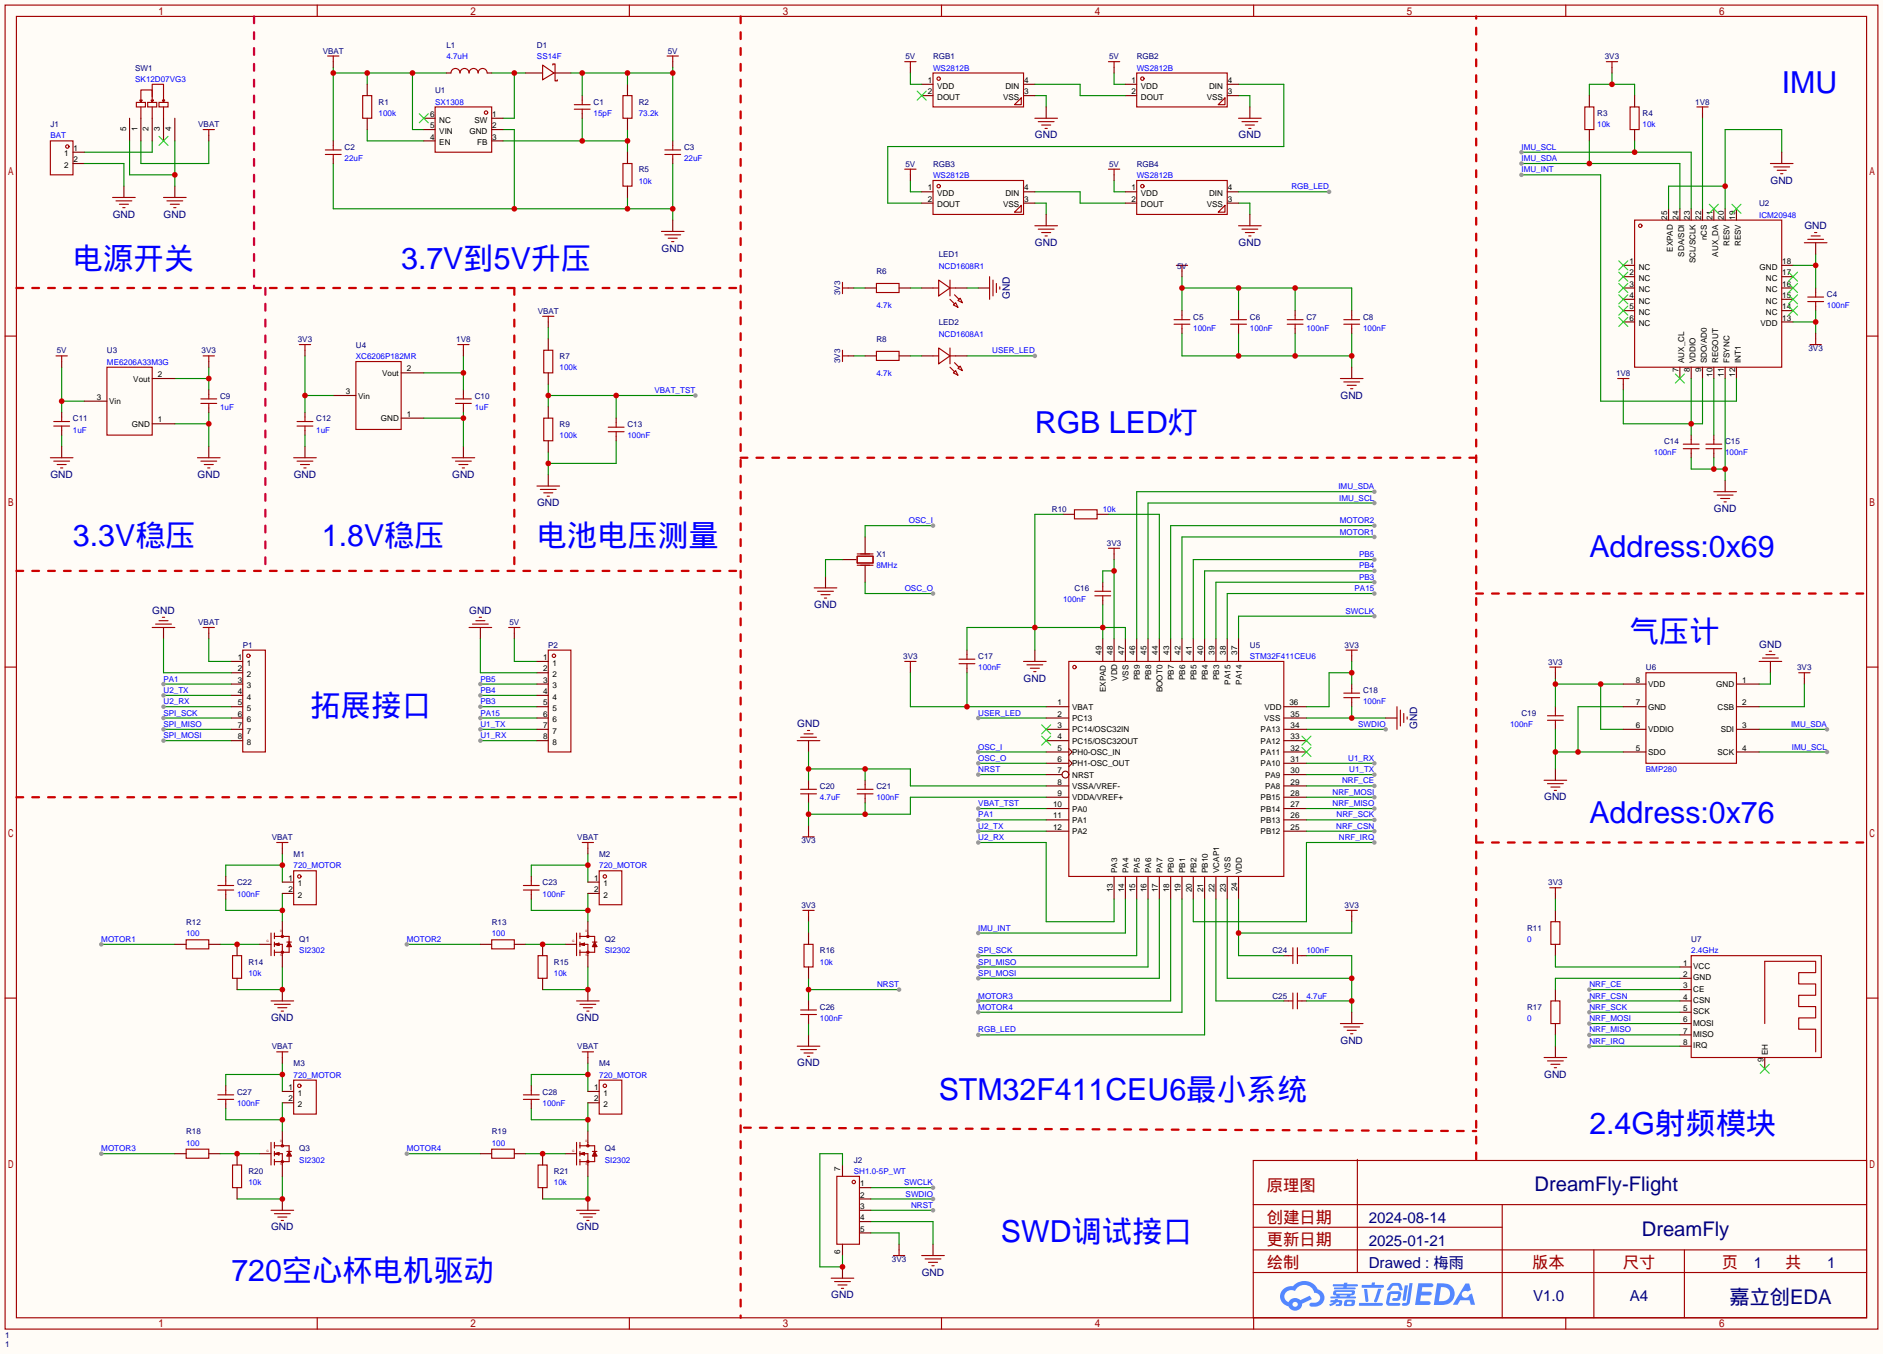
[picture p6: page 1]

RESV 19 RESV 20 AUX_DA 21 nCS 22 SCL/SCLK 23 SDA/SDI 24 EXPAD 25
