MeiRain/DreamFly2/docs/PDF_DreamFly_2026-09-01/Schematic2/SCH_Schematic2_1-DreamFly-Remote_2026-09-01.pdf

# 3.7V到5V升压

# RGB LED灯

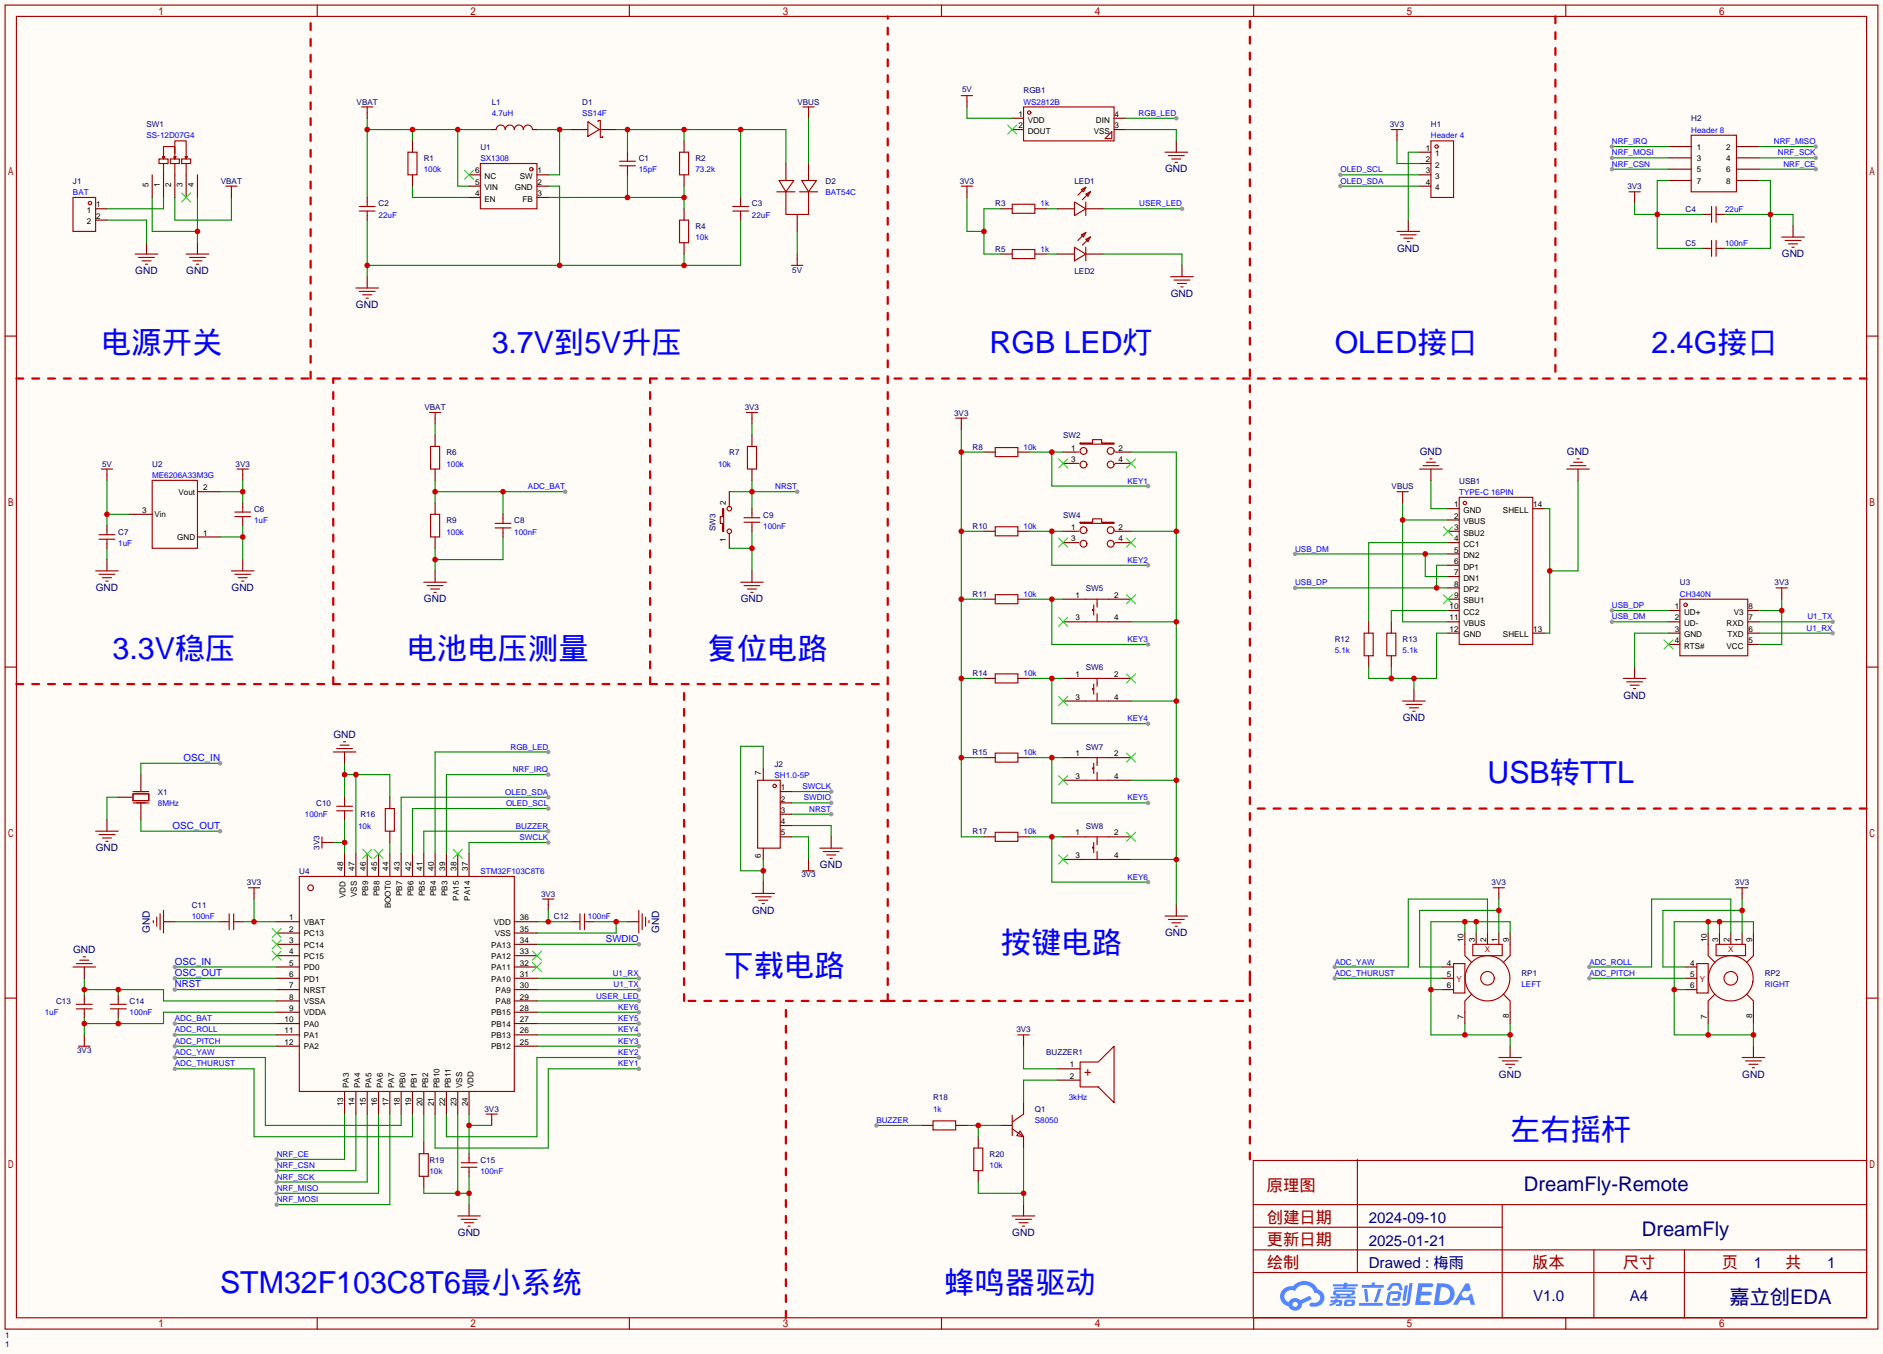
[picture p7: page 1]

OLED_SCL

BUZZER
SWCLK
