MeiRain/DreamFly2/docs/PDF_DreamFly_2026-09-01/Schematic3/SCH_Schematic3_1-DreamFly-OpticalFlow_2026-09-01.pdf

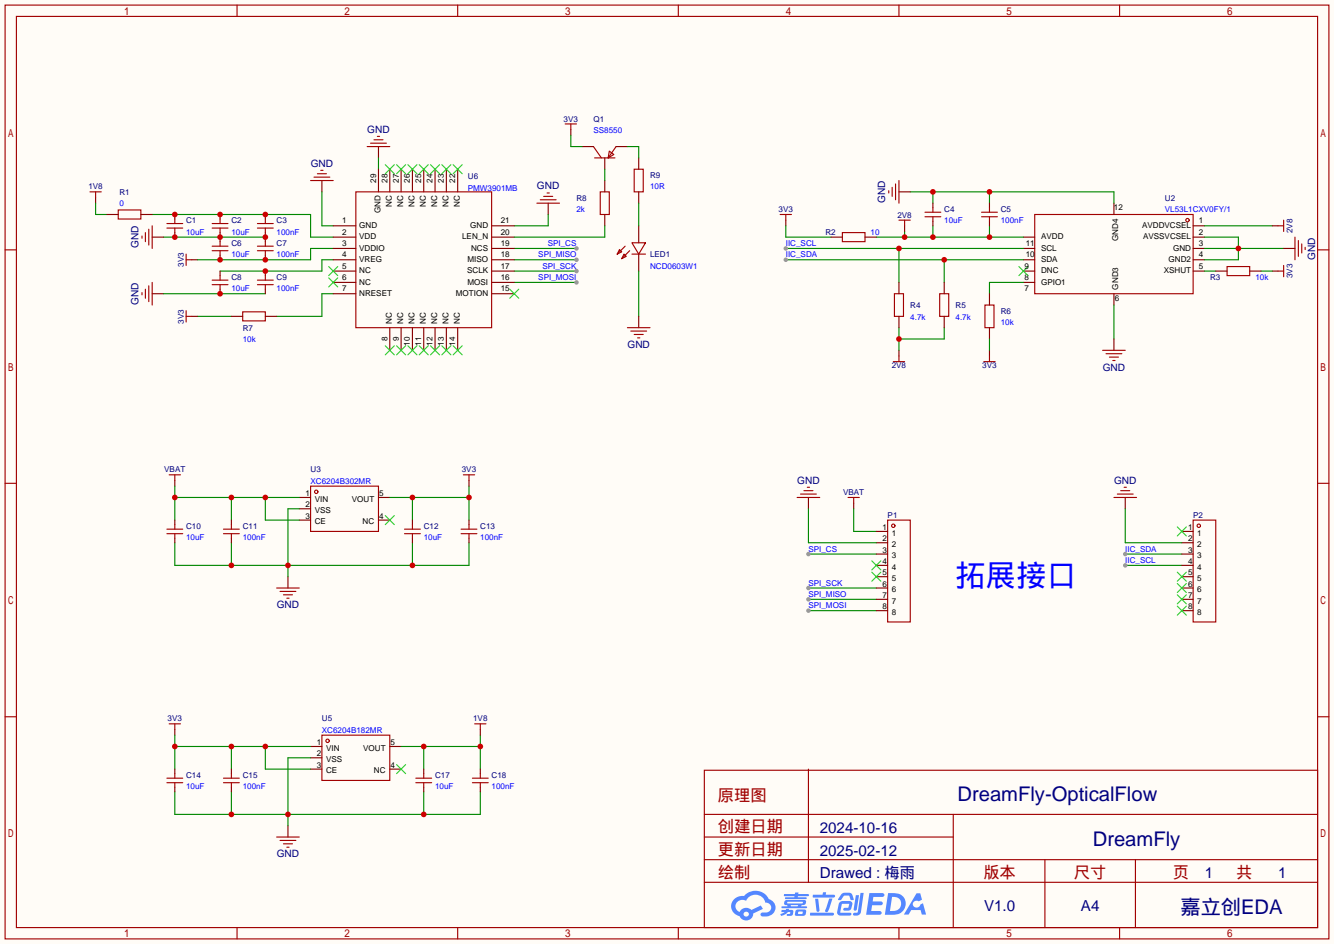
[picture p8: page 1]
