MeiRain/DreamFly2/docs/PDF_DreamFly_2026-09-01/Schematic4/SCH_Schematic4_1-DreamFly-DataTransfer_2026-09-01.pdf

# NC8 25 IO18 26 IO19 27 NC9 28 NC10 29 RXD0 30 TXD0 31 NC11 32 NC12 33 NC13 34 NC14 35

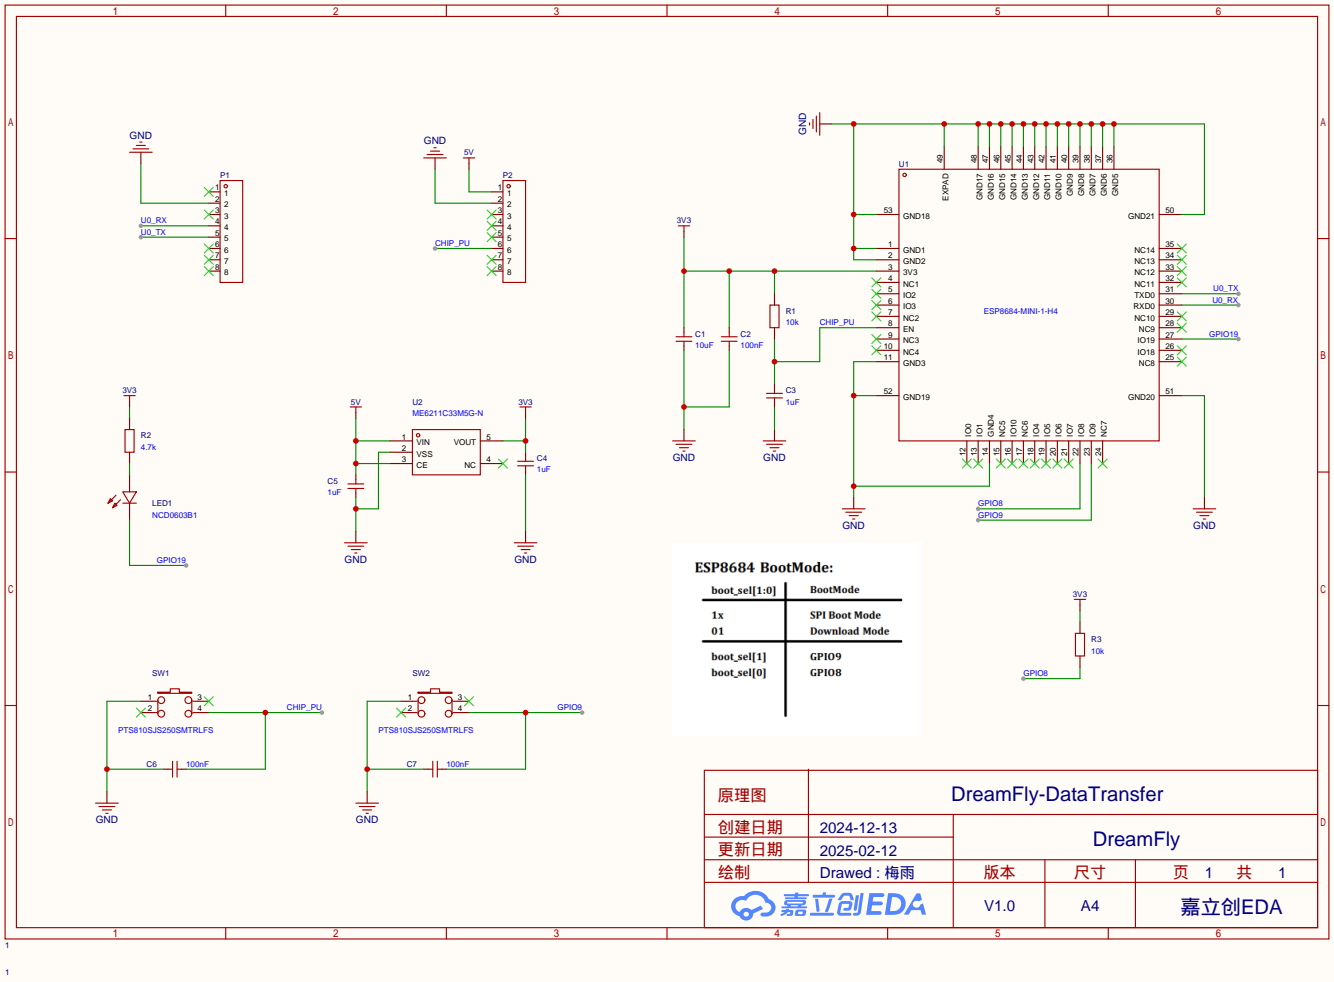
[picture p9: page 1]
