MeiRain/DreamFly2/(list of files, drawings)

Other design files:
hardware/dreamfly/DreamFly.epro
