MeiRain/DreamFly2/firmware/dreamfly2_flight/Application/sensors.c

/**
 * @file sensors.c
 * @brief Sensor application logic has moved to flight.c.
 * @author 梅雨
 * @date 2026-10-11
 */

/* Intentionally empty: retained only for the existing CMake source list.
 * Remove Application/sensors.c from that list before deleting this file.
 */
