MeiRain/DreamFly2/firmware/dreamfly2_flight/Application/sensors.h

/**
 * @file sensors.h
 * @brief Sensor application types and functions have moved to flight.h/flight.c.
 * @author 梅雨
 * @date 2026-10-11
 */

#ifndef DREAMFLY2_APPLICATION_SENSORS_H
#define DREAMFLY2_APPLICATION_SENSORS_H

/* Retired interface. Application code now includes flight.h. */

#endif /* DREAMFLY2_APPLICATION_SENSORS_H */
