MeiRain/DreamFly2/firmware/dreamfly2_remote/Components/OLED/oledfont.c

/**
 * @file oledfont.c
 * @brief OLED fonts and icons adapted from Jiangxie Technology.
 * @date 2026-10-24
 * @note Original copyright: Jiangxie Technology, jiangxiekeji.com.
 *       Original glyph labels and data comments are retained.
 */

#include "oledfont.h"

/**
  * 数据存储格式：
  * 纵向8点，高位在下，先从左到右，再从上到下
  * 每一个Bit对应一个像素点
  * 
  *      B0 B0                  B0 B0
  *      B1 B1                  B1 B1
  *      B2 B2                  B2 B2
  *      B3 B3  ------------->  B3 B3 --
  *      B4 B4                  B4 B4  |
  *      B5 B5                  B5 B5  |
  *      B6 B6                  B6 B6  |
  *      B7 B7                  B7 B7  |
  *                                    |
  *  -----------------------------------
  *  |   
  *  |   B0 B0                  B0 B0
  *  |   B1 B1                  B1 B1
  *  |   B2 B2                  B2 B2
  *  --> B3 B3  ------------->  B3 B3
  *      B4 B4                  B4 B4
  *      B5 B5                  B5 B5
  *      B6 B6                  B6 B6
  *      B7 B7                  B7 B7
  * 
  */

/*ASCII字模数据*********************/

/*宽8像素，高16像素*/
const uint8_t oled_font_8x16[][16] =
{
    {0x00, 0x00, 0x00, 0x00, 0x00, 0x00, 0x00, 0x00, 0x00, 0x00, 0x00, 0x00, 0x00, 0x00, 0x00, 0x00},
    {0x00, 0x00, 0x00, 0xF8, 0x00, 0x00, 0x00, 0x00, 0x00, 0x00, 0x00, 0x33, 0x30, 0x00, 0x00, 0x00},
    {0x00, 0x16, 0x0E, 0x00, 0x16, 0x0E, 0x00, 0x00, 0x00, 0x00, 0x00, 0x00, 0x00, 0x00, 0x00, 0x00},
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
	0x1C,0x3C,0x64,0xC4,0x84,0x84,0xC4,0x64,0x3C,0x1C,0x00,0x00,0x00,0x00,0xE0,0xE0,
	0x00,0x00,0x00,0x00,0x3F,0x3F,0x00,0x00,0x38,0x38,0x00,0x3F,0x3F,0x00,0x3F,0x3F,
};

/*********************图像数据*/


/*****************江协科技|版权所有****************/
/*****************jiangxiekeji.com*****************/
