MeiRain/DreamFly2/(commit log)

2026-10-10 feat: add flight hardware drivers and RTOS task structure
2026-10-12 refactor: decouple ANO protocol packing from UART transmission
2026-10-26 feat: integrate remote control link and flight telemetry
    Add remote joystick calibration, two-page OLED interface, and telemetry display. Update project configuration and organize hardware, protocol, and coding documentation.
2026-10-28 feat: integrate flight tuning, persistence, and motor bench control
    Consolidate flight initialization, sensor processing, RC arming, and motor output arbitration.
    Add barometric/inertial height estimation and CRC-checked attitude parameter storage.
    Implement ANO V8 parameter discovery, read/write, defaults, and save commands over UART2.
    Add a propeller-off zero-rate motor bench with bounded output and stale-data disarming.
    Refine remote telemetry pages, joystick processing, radio IRQ handling, and RGB support.
    Include required build/Flash configuration, lowercase RGB filenames, and measurement records.
    Validation: offline protocol and motor-policy models; UART2 parameter read/write,
    save an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
2026-10-29 feat: add cascaded attitude control and single-centering throttle
    Update remote calibration, motor output, IMU startup timing, and project documentation. Import the VL53L1X ULD API for upcoming software I2C integration.
